Clewsy/volcon/PCB (Eagle)/VolCon/IMG_20150405_195725.jpg

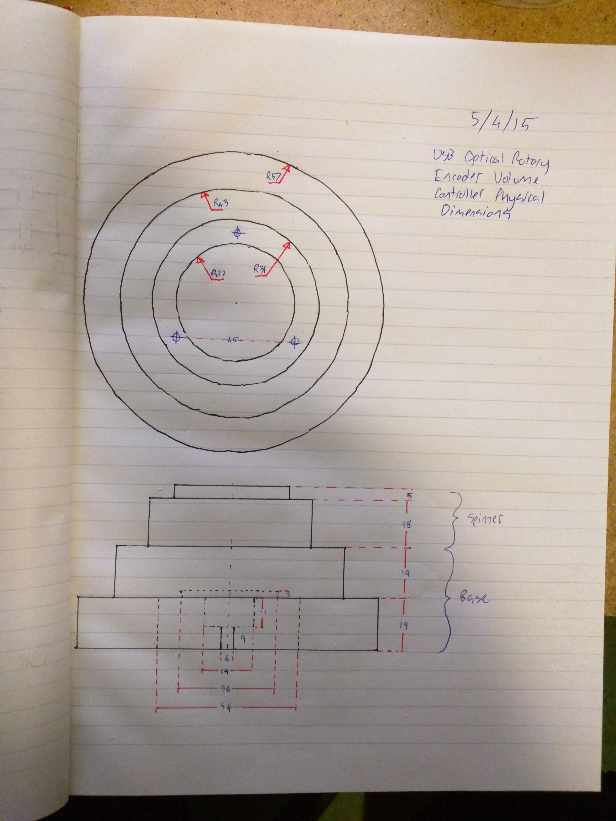
PCB (Eagle)/VolCon/IMG_20150405_195725.jpg
