Clewsy/volcon/PCB (Eagle)/VolCon/IMG_20150405_195736.jpg

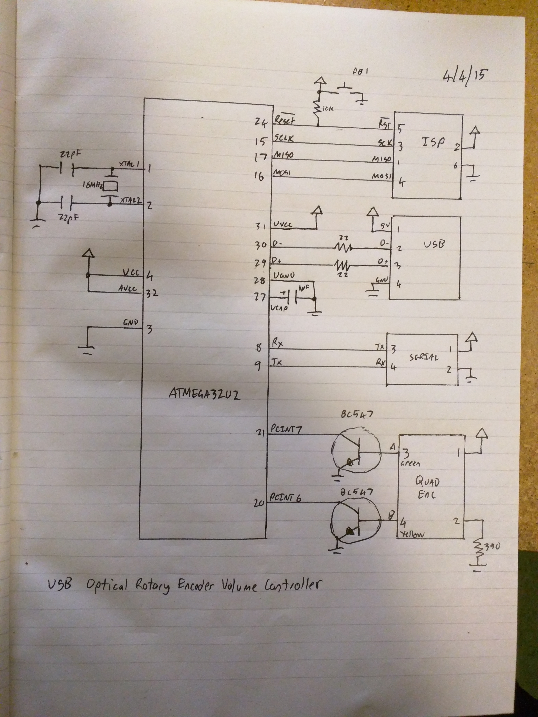
PCB (Eagle)/VolCon/IMG_20150405_195736.jpg
