Clewsy/volcon/PCB (Eagle)/VolCon/IMG_20150405_195748.jpg

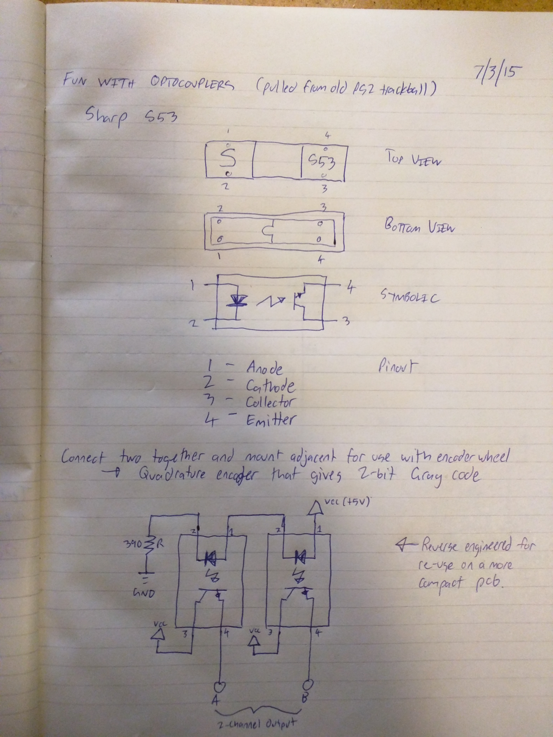
PCB (Eagle)/VolCon/IMG_20150405_195748.jpg
