Clewsy/volcon/PCB (Eagle)/VolCon/ISP-6.jpg

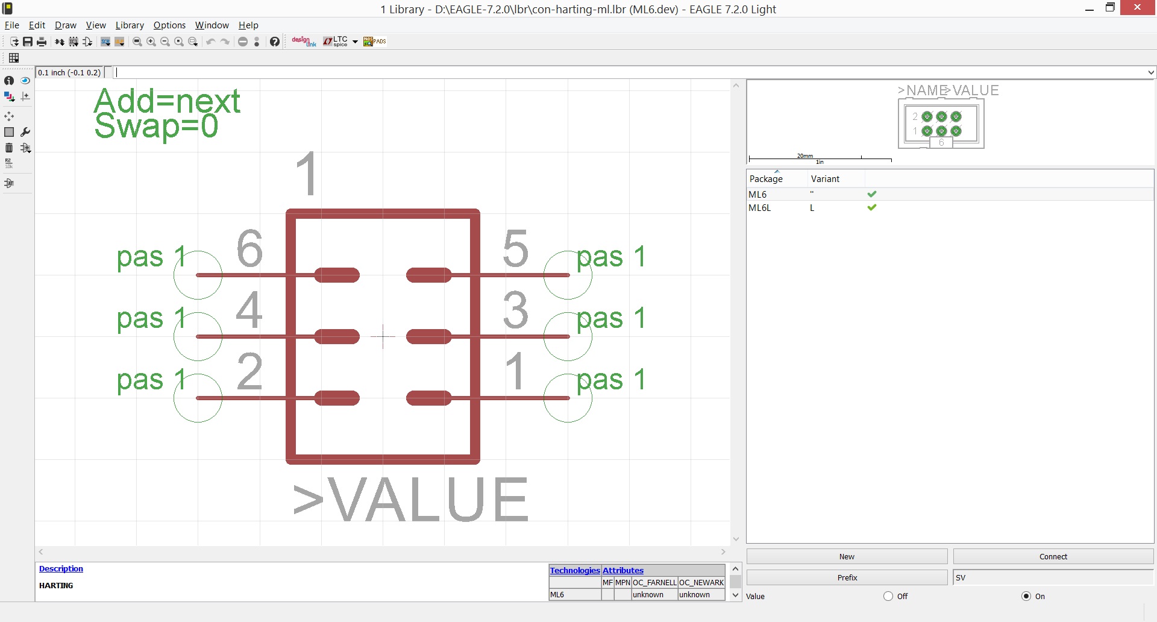
PCB (Eagle)/VolCon/ISP-6.jpg
