Clewsy/volcon/hardware/schematic.pdf

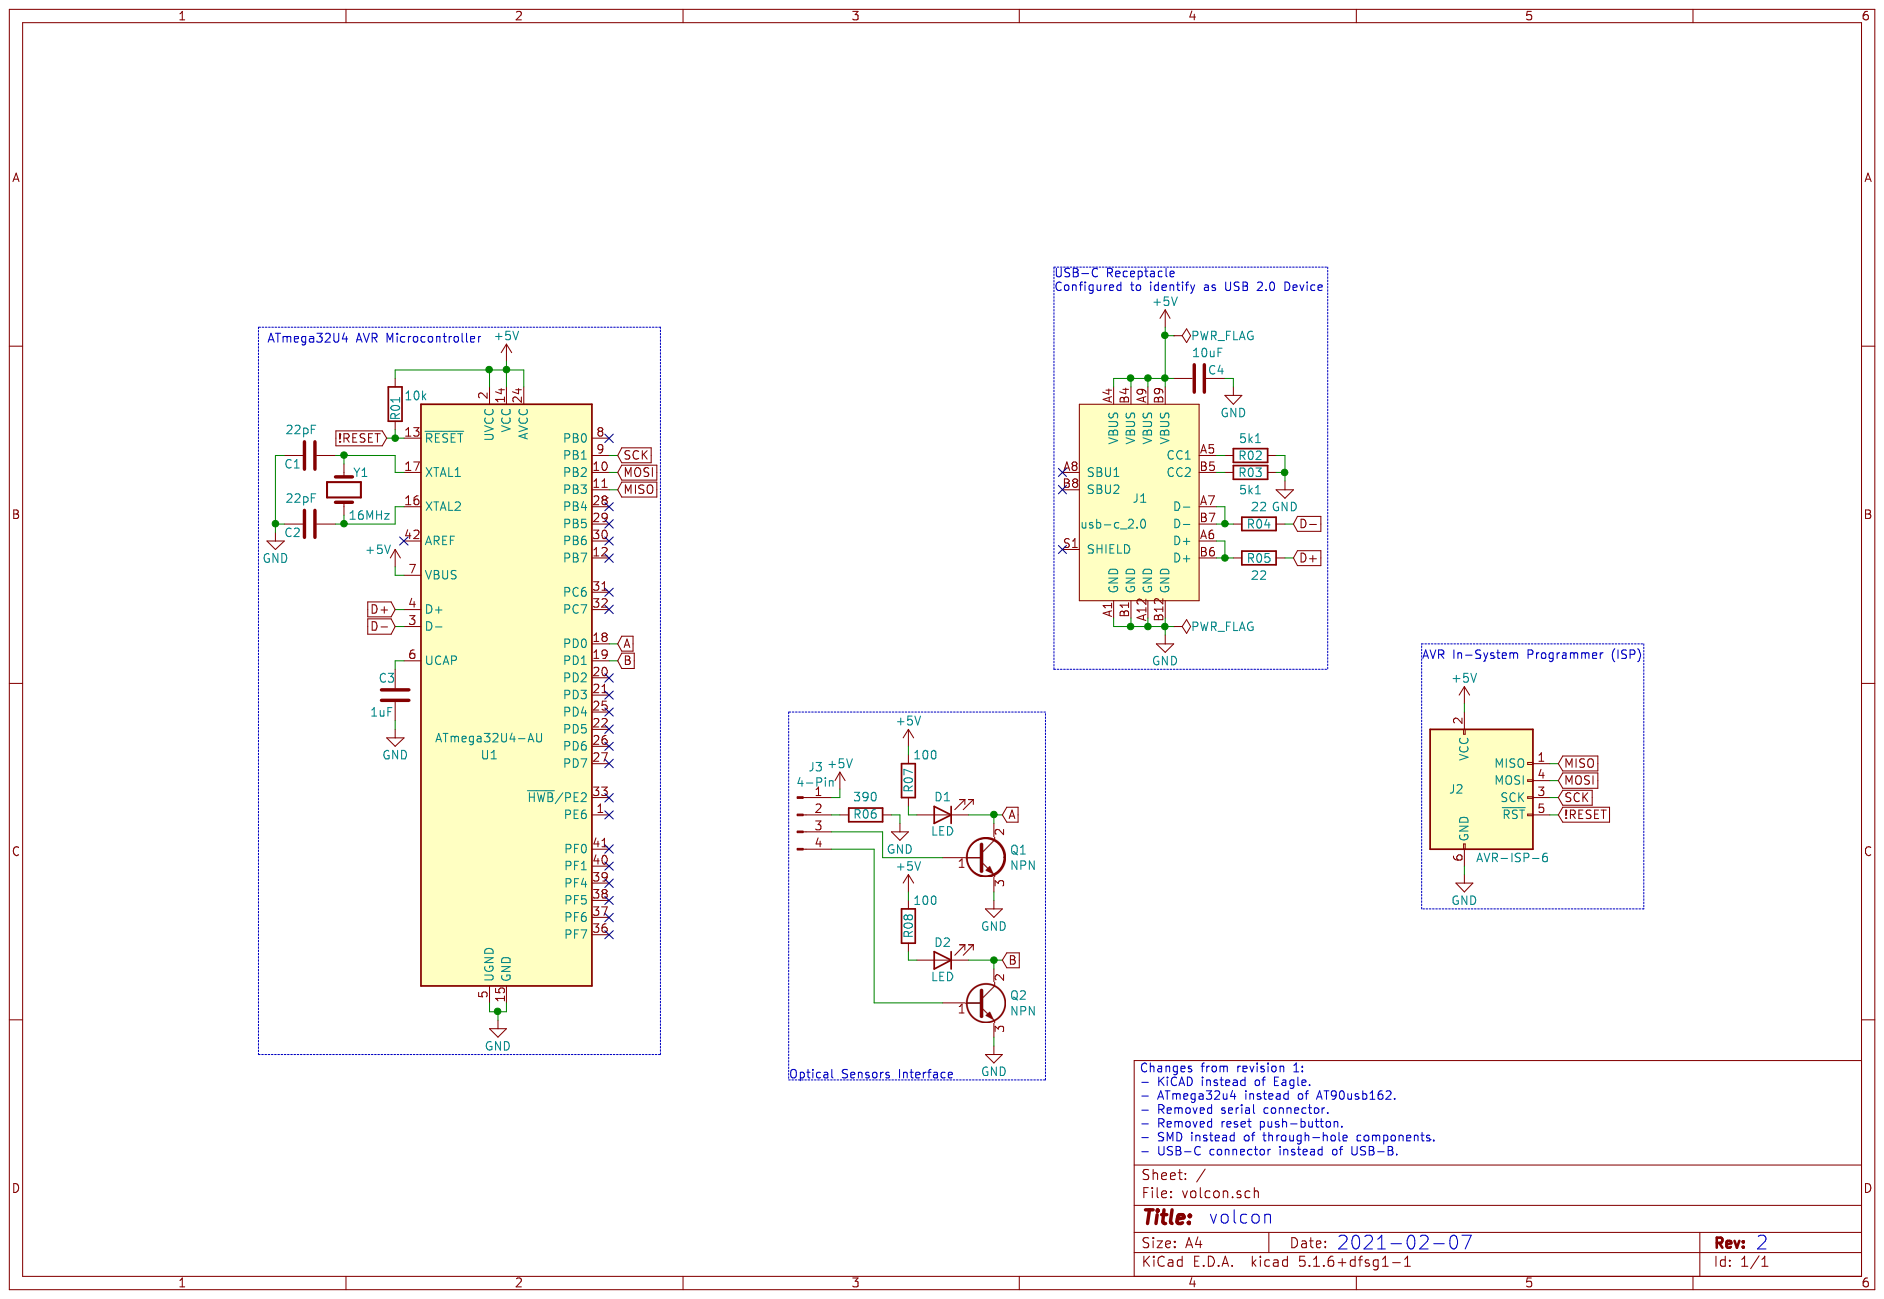
[picture p14: page 1]
