Clewsy/volcon/PCB (Eagle)/VolCon/VolCon/VolCon.pdf

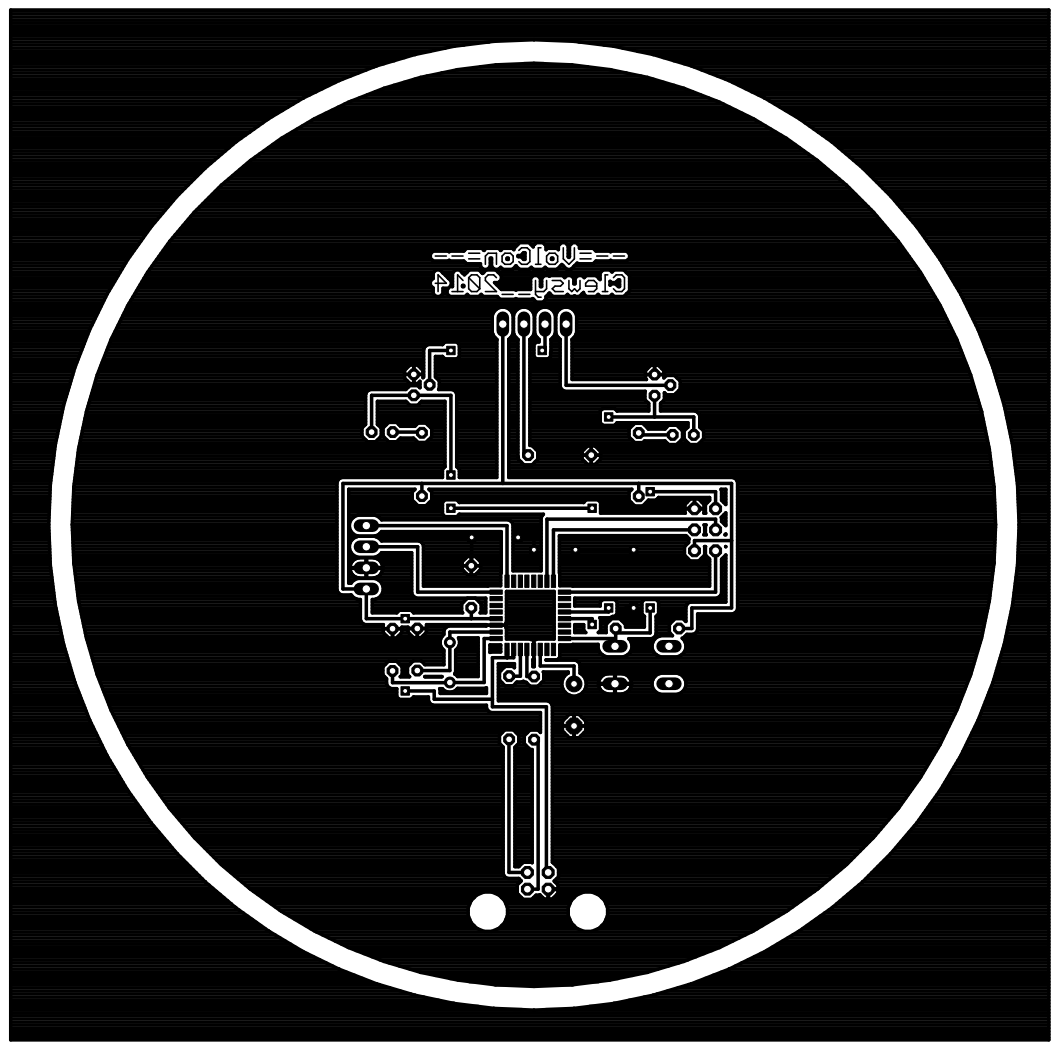
[picture p15: page 1]
