Clewsy/volcon/PCB (Eagle)/VolCon/VolCon/VolCon_ENC.pdf

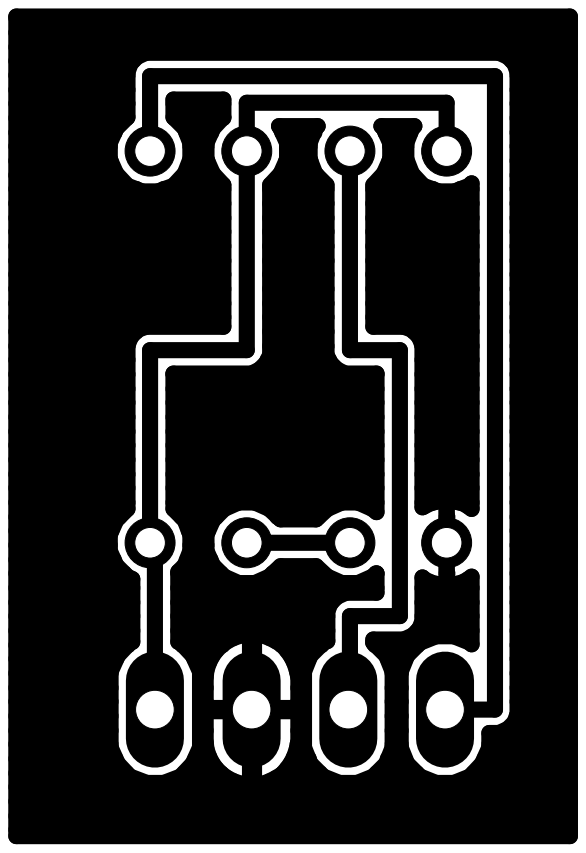
[picture p16: page 1]
