Clewsy/volcon/hardware/volcon.kicad_pcb

## KiCad design hardware/volcon.kicad_pcb (2021-02-07)

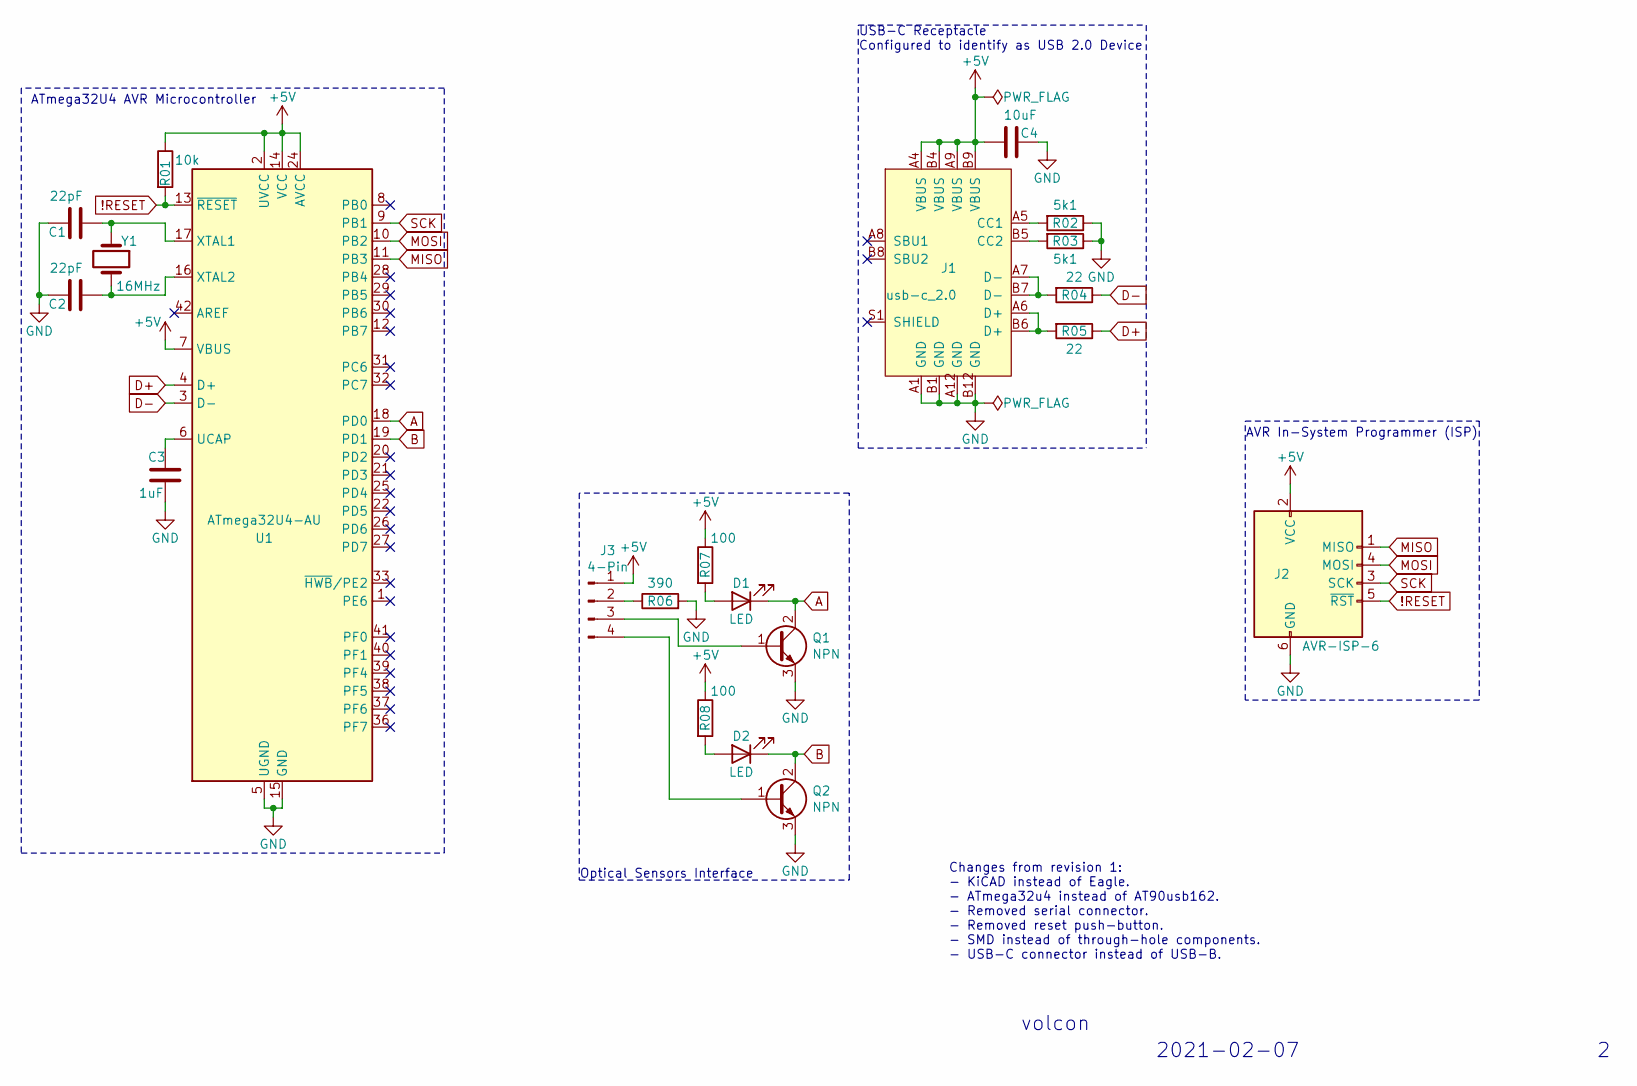
[picture p17: schematic volcon.sch]

Parts:
C1, C2: 22pF; C_1206_3216Metric_Pad1.42x1.75mm_HandSolder
C3: 1uF; C_1206_3216Metric_Pad1.42x1.75mm_HandSolder
C4: 10uF; C_1206_3216Metric_Pad1.42x1.75mm_HandSolder
D1, D2: LED; LED_Cree-XQ_HandSoldering
J1: usb-c_2.0; USB_C_Receptacle_GCT_USB4085
J2: AVR-ISP-6; IDC-Header_2x03_P2.54mm_Vertical
J3: 4-Pin; PinHeader_1x04_P2.54mm_Vertical
Q1, Q2: NPN; SOT-223-3_TabPin2
R01: 10k; R_1206_3216Metric_Pad1.42x1.75mm_HandSolder
R02, R03: 5k1; R_1206_3216Metric_Pad1.42x1.75mm_HandSolder
R04, R05: 22; R_1206_3216Metric_Pad1.42x1.75mm_HandSolder
R06: 390; R_1206_3216Metric_Pad1.42x1.75mm_HandSolder
R07, R08: 100; R_1206_3216Metric_Pad1.42x1.75mm_HandSolder
U1: ATmega32U4-AU; TQFP-44_10x10mm_P0.8mm
Y1: 16MHz; Crystal_SMD_HC49-SD

Connections:
!RESET: J2.5 (~RST), R01.2, U1.13 (~RESET)
+5V: C4.2, J1.A4 (VBUS), J1.A9 (VBUS), J1.B4 (VBUS), J1.B9 (VBUS), J2.2 (VCC), J3.1, R01.1, R07.1, R08.1, U1.2 (UVCC), U1.7 (VBUS), U1.14 (VCC), U1.24 (AVCC), U1.34 (VCC), U1.44 (AVCC)
A: D1.1 (K), Q1.2 (C), U1.18 (PD0)
B: D2.1 (K), Q2.2 (C), U1.19 (PD1)
D+: R05.1, U1.4 (D+)
D-: R04.1, U1.3 (D-)
GND: C1.2, C2.2, C3.2, C4.1, J1.A1 (GND), J1.A12 (GND), J1.B1 (GND), J1.B12 (GND), J2.6 (GND), Q1.3 (E), Q2.3 (E), R02.1, R03.1, R06.2, U1.5 (UGND), U1.15 (GND), U1.23 (GND), U1.35 (GND), U1.43 (GND)
MISO: J2.1 (MISO), U1.11 (PB3)
MOSI: J2.4 (MOSI), U1.10 (PB2)
unnamed: C1.1, U1.17 (XTAL1), Y1.1
unnamed: C2.1, U1.16 (XTAL2), Y1.2
unnamed: C3.1, U1.6 (UCAP)
unnamed: D1.2 (A), R07.2
unnamed: D2.2 (A), R08.2
unnamed: J1.A5 (CC1), R02.2
unnamed: J1.A6 (D+), J1.B6 (D+), R05.2
unnamed: J1.A7 (D-), J1.B7 (D-), R04.2
unnamed: J1.B5 (CC2), R03.2
unnamed: J3.2, R06.1
unnamed: J3.3, Q1.1 (B)
unnamed: J3.4, Q2.1 (B)
SCK: J2.3 (SCK), U1.9 (PB1)

Notes on the sheet:
volcon
2021-02-07
ATmega32U4 AVR Microcontroller
Optical Sensors Interface
AVR In-System Programmer (ISP)
USB-C Receptacle Configured to identify as USB 2.0 Device
Changes from revision 1: - KiCAD instead of Eagle. - ATmega32u4 instead of AT90usb162. - Removed serial connector. - Removed reset push-button. - SMD instead of through-hole components. - USB-C connector instead of USB-B.

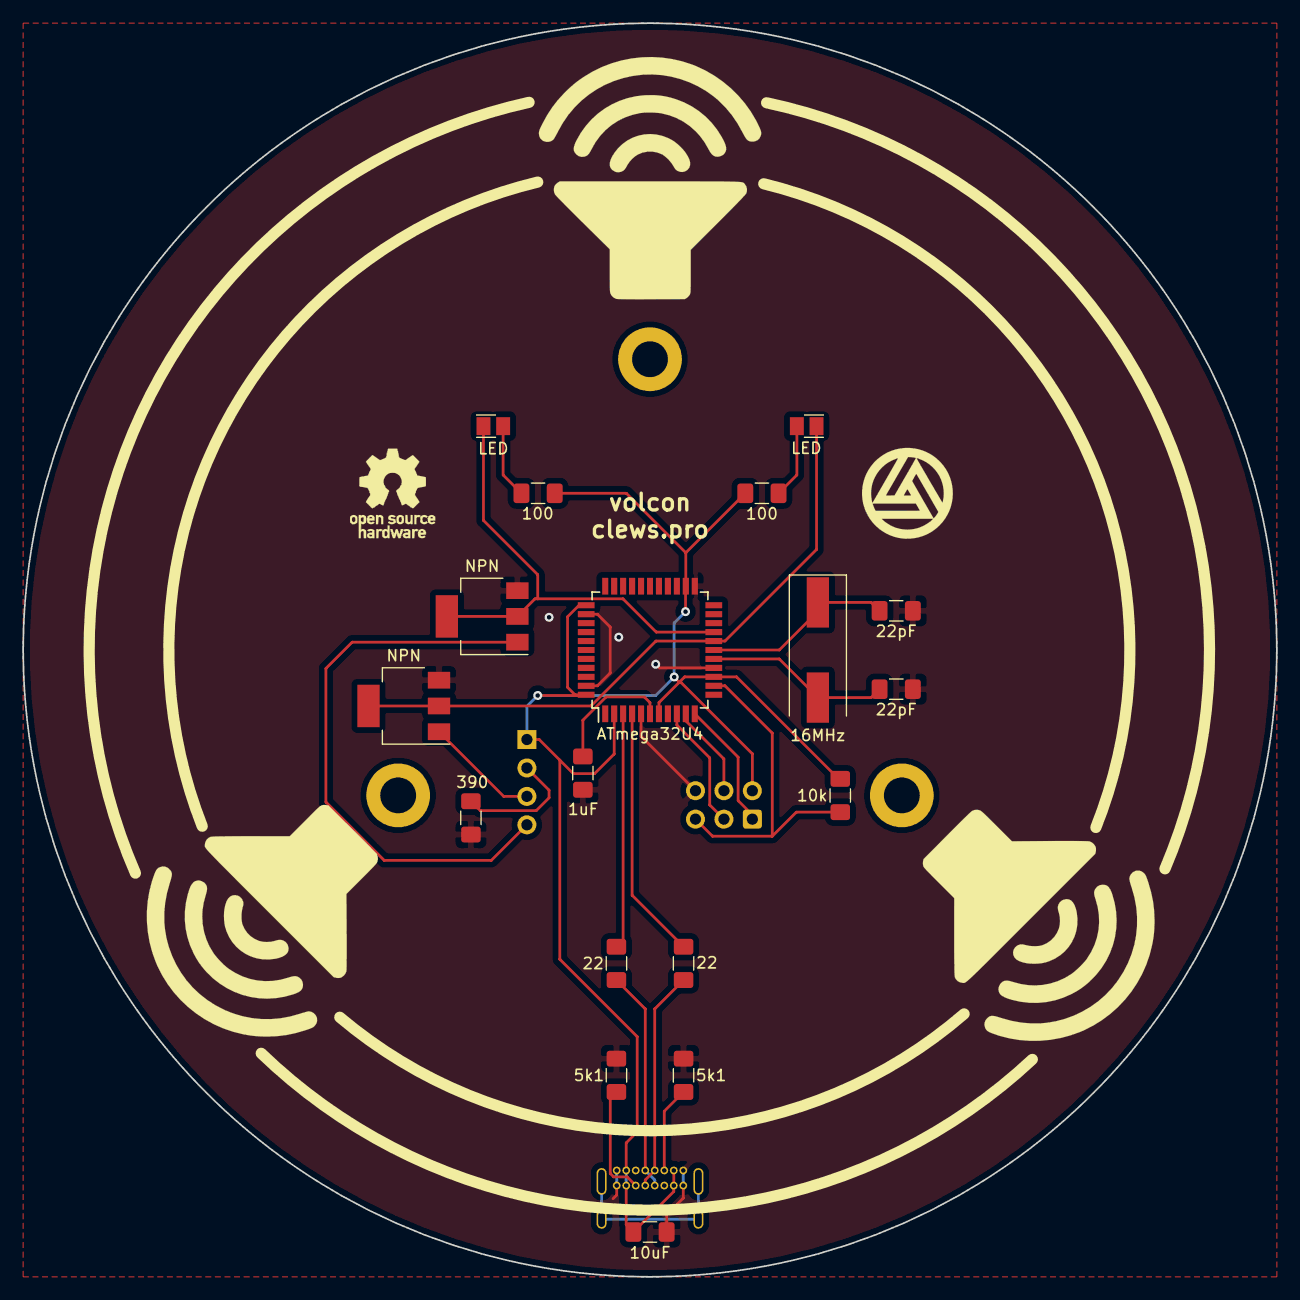
[picture p18: board volcon.kicad_pcb from above]

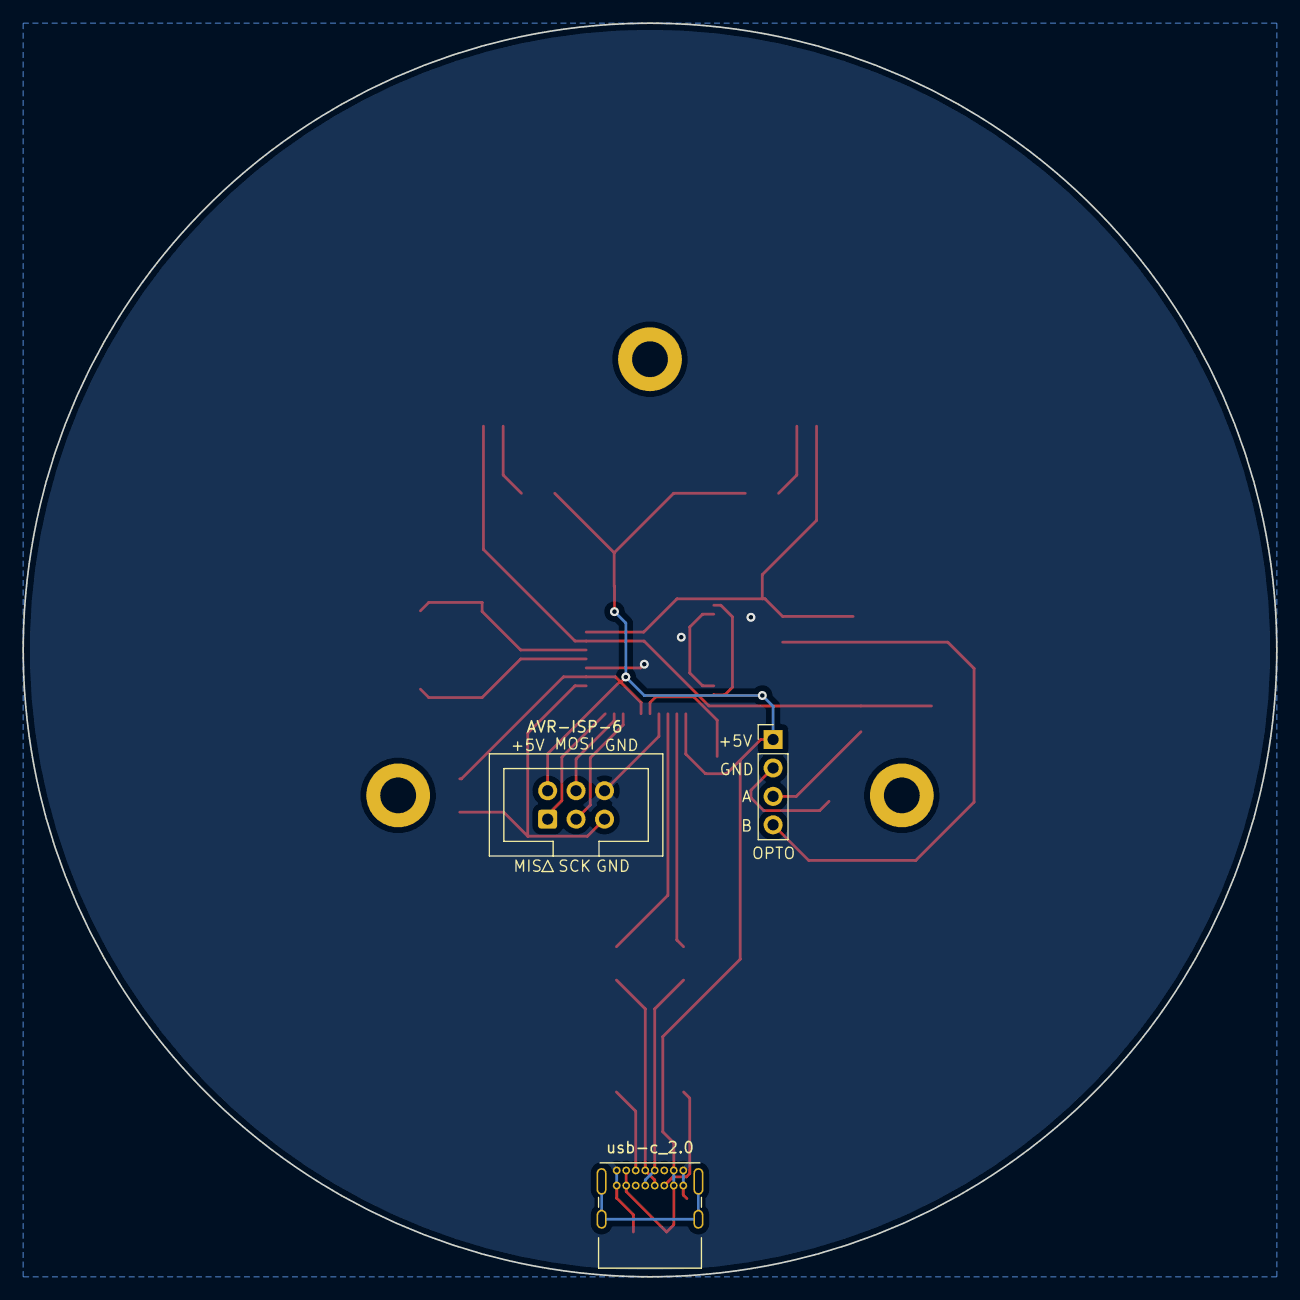
[picture p19: board volcon.kicad_pcb from below]

Board: 2 copper layers, 112.0 x 112.0 mm, 21 parts (3 on the bottom side), 22 nets.
