Clewsy/volcon/PCB (Eagle)/VolCon/VolCon/VolCon_ENC.brd

## EAGLE design PCB (Eagle)/VolCon/VolCon/VolCon_ENC.brd (2016-07-20)

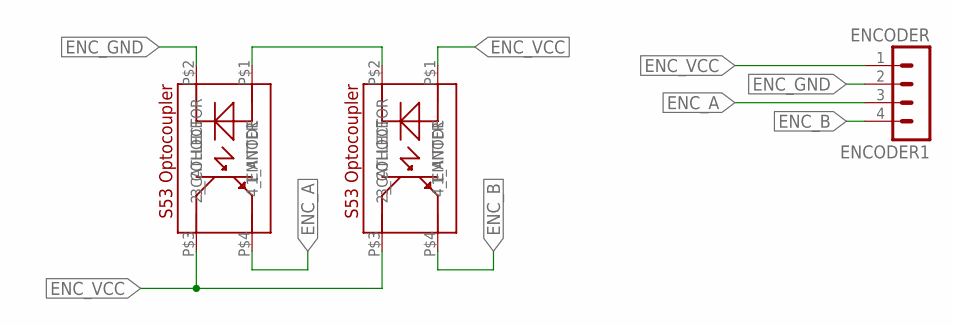
[picture p20: schematic VolCon_ENC.sch]

Parts:
ENCODER1: ENCODER; MA04-1
U$3, U$4: SHARP_S53

Connections:
ENC_A: ENCODER1.3, U$4.P$4 (4_EMITTER)
ENC_B: ENCODER1.4, U$3.P$4 (4_EMITTER)
ENC_GND: ENCODER1.2, U$4.P$2 (2_CATHODE)
ENC_VCC: ENCODER1.1, U$3.P$1 (1_ANODE), U$3.P$3 (3_COLLECTOR), U$4.P$3 (3_COLLECTOR)
unnamed: U$3.P$2 (2_CATHODE), U$4.P$1 (1_ANODE)

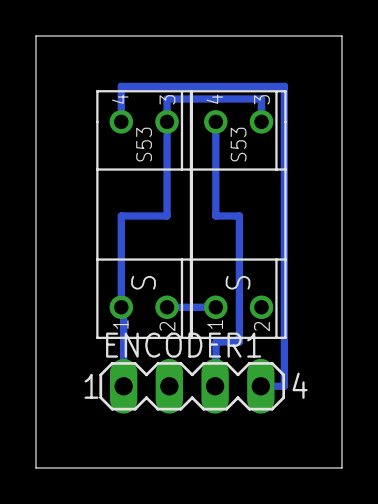
[picture p21: board VolCon_ENC.brd from above]

Board: 2 copper layers, 17.0 x 24.0 mm, 3 parts (0 on the bottom side), 5 nets.
