Clewsy/volcon/PCB (Eagle)/VolCon/VolCon/VolCon.brd

## EAGLE design PCB (Eagle)/VolCon/VolCon/VolCon.brd (2016-07-20)

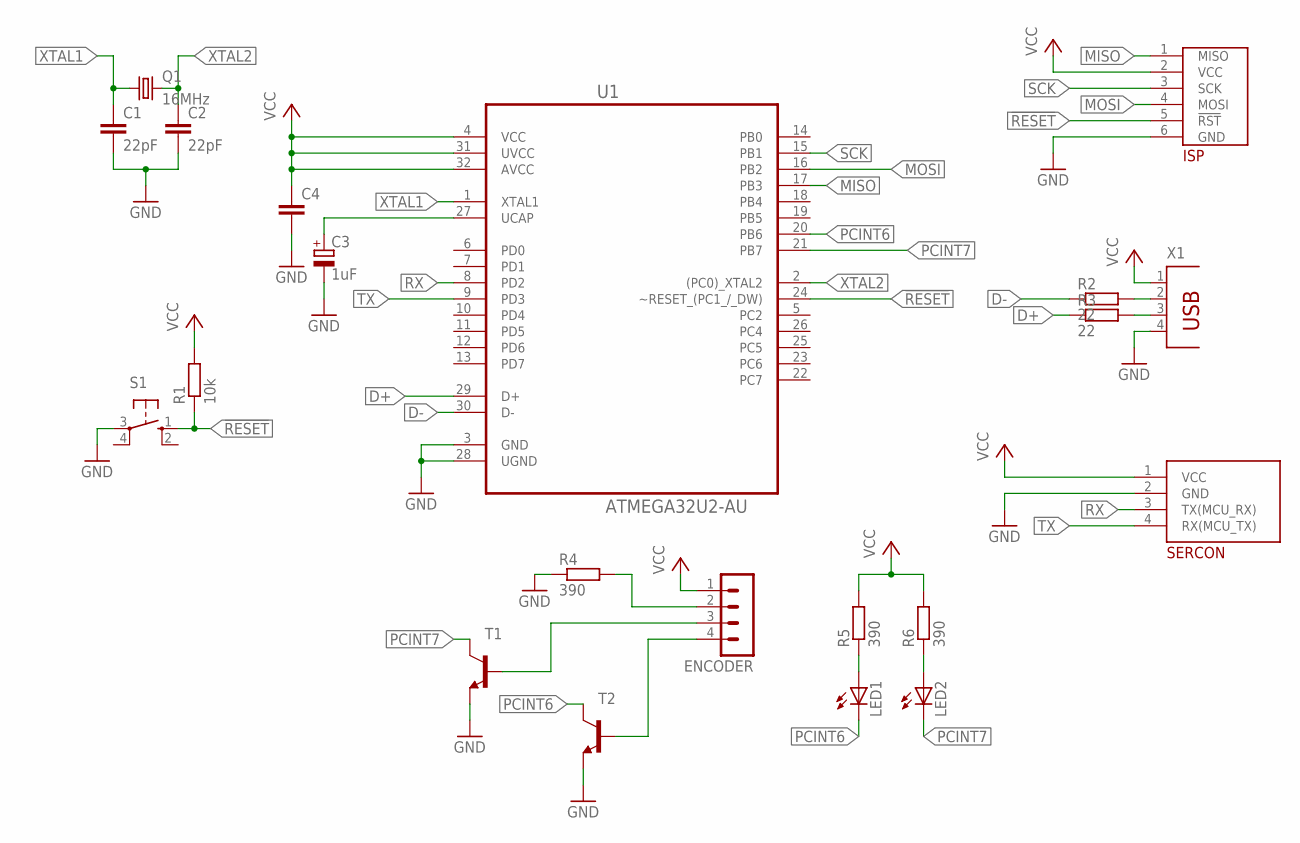
[picture p22: schematic VolCon.sch]

Parts:
C1, C2: 22pF; C050-024X044
C3: 1uF; E5-6
C4: C-EU050-025X075; C050-025X075
ENCODER: MA04-1
LED1, LED2: LED5MM
Q1: 16MHz; HC49/S
R1: 10k; 0204/7
R2, R3: 22; 0204/7
R4, R5, R6: 390; 0204/7
S1: 10-XX; B3F-10XX
T1, T2: 2N3565; TO92
U1: ATMEGA32U2-AU; QFP80P900X900X120-32N
U$1: ISP-6
U$2: SERCON
X1: PN61729

Connections:
!RESET: R1.1, S1.1 (S), U1.24 (~RESET_(PC1_/_DW)), U$1.5 (!RST)
D+: R3.1, U1.29 (D+)
D-: R2.1, U1.30 (D-)
GND: C1.2, C2.2, C3.-, C4.2, R4.1, S1.3, T1.3 (E), T2.3 (E), U1.3 (GND), U1.28 (UGND), U$1.6 (GND), U$2.2 (GND), X1.4
MISO: U1.17 (PB3), U$1.1 (MISO)
MOSI: U1.16 (PB2), U$1.4 (MOSI)
unnamed: R2.2, X1.2
unnamed: R3.2, X1.3
unnamed: ENCODER.3, T1.2 (B)
unnamed: ENCODER.4, T2.2 (B)
unnamed: ENCODER.2, R4.2
unnamed: LED1.A, R5.1
unnamed: LED2.A, R6.1
PCINT6: LED1.K (C), T2.1 (C), U1.20 (PB6)
PCINT7: LED2.K (C), T1.1 (C), U1.21 (PB7)
RX: U1.8 (PD2), U$2.3 (TX(MCU_RX))
SCK: U1.15 (PB1), U$1.3 (SCK)
TX: U1.9 (PD3), U$2.4 (RX(MCU_TX))
UCAP: C3.+, U1.27 (UCAP)
VCC: C4.1, ENCODER.1, R1.2, R5.2, R6.2, U1.4 (VCC), U1.31 (UVCC), U1.32 (AVCC), U$1.2 (VCC), U$2.1 (VCC), X1.1
XTAL1: C1.1, Q1.1, U1.1 (XTAL1)
XTAL2: C2.1, Q1.2, U1.2 ((PC0)_XTAL2)

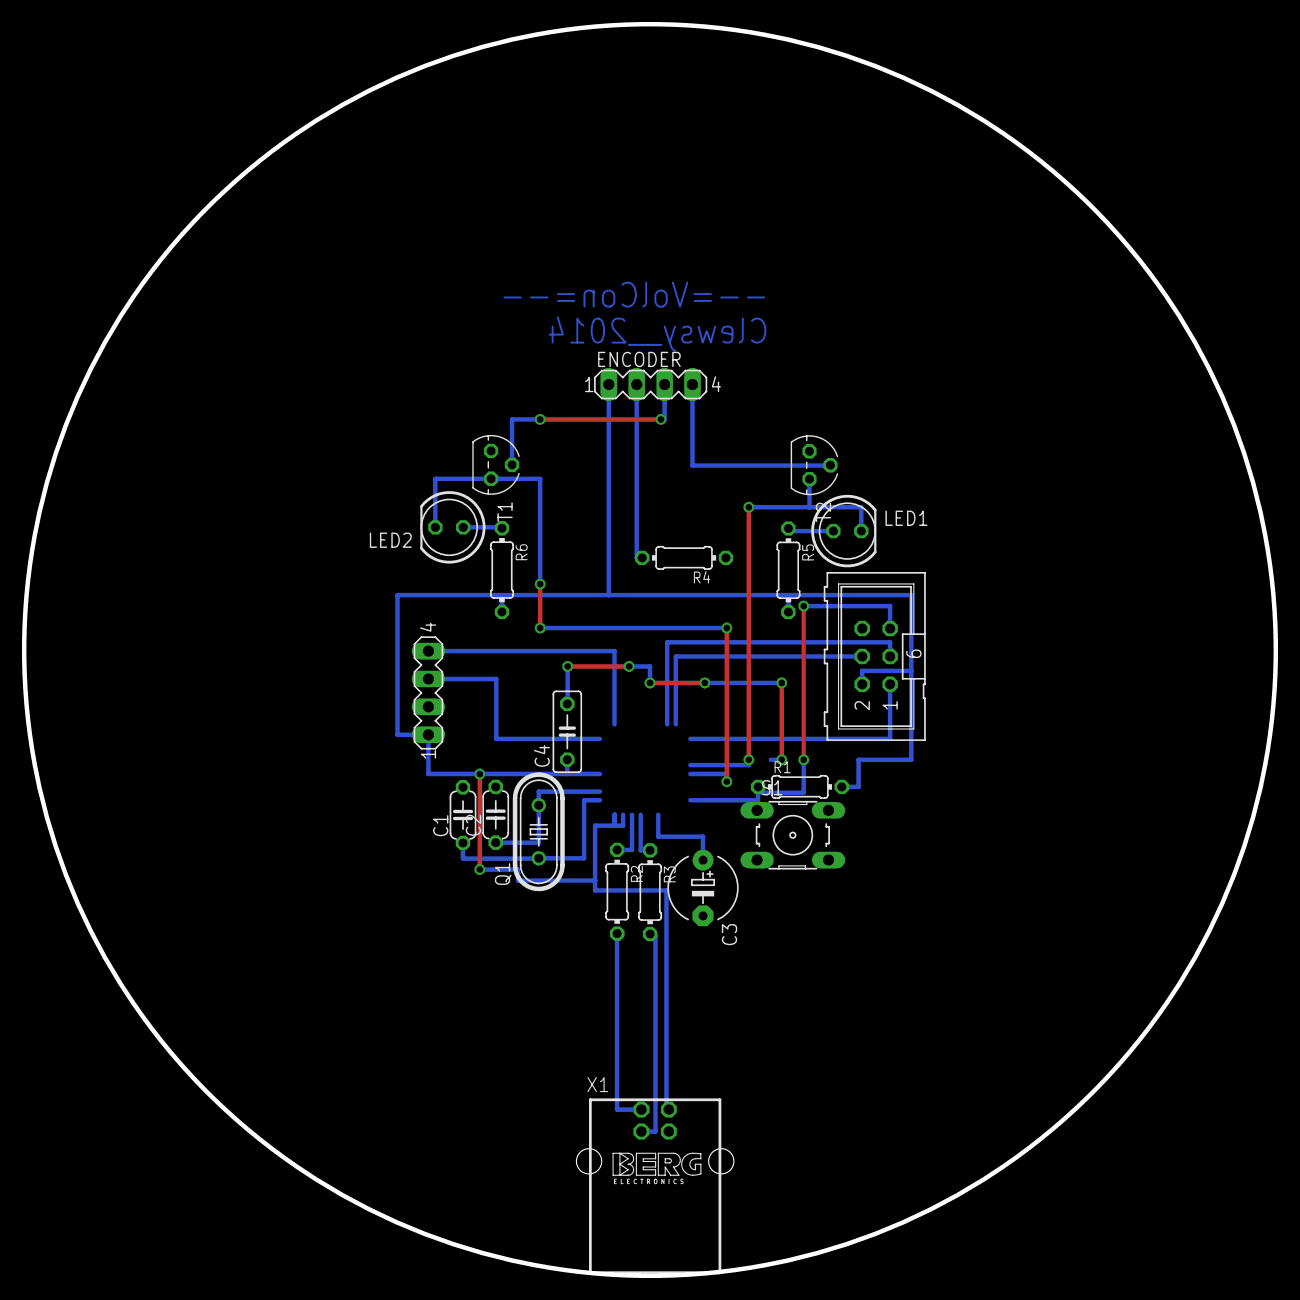
[picture p23: board VolCon.brd from above]

Board: 2 copper layers, 114.0 x 114.0 mm, 21 parts (1 on the bottom side), 22 nets.
