Clewsy/volcon/(commit log)

2021-01-26 Beginning a second revision.
    [VolCon.brd, VolCon.sch, VolCon_ENC.brd, VolCon_ENC.sch, volcon.kicad_pcb, volcon.sch]
2021-01-26 Compressed earlier revision.
    [VolCon.brd, VolCon.sch, VolCon_ENC.brd, VolCon_ENC.sch]
2021-01-26 Ignore exported gerber files.
2021-02-07 Minor adjustments, clean-up and comments. Generated schematic pdf for repo.
    [volcon.kicad_pcb, volcon.sch]
2021-02-12 Fixed some comment typos and tidied some code for readability.
    [volcon.c, volcon.h, volume_control.c]
2026-06-20 3d-printed cap
